andykarpov/karabas-128/README.md

# Karabas-128

**Yet another ZX Spectrum clone ;)**

## Intro

ZX Spectrum 128k replica with real **Z80** CPU and almost all logic in CPLD Altera **EPM7128STC100**. PCB designed to fit into original ZX Spectrum 48k (rubber keys) case.

## The idea

The idea was to make a **cheap** ZX Spectrum 128k clone with minimum components. Some parts of this schematics are grabbed from the **Superfo's Harlequin 48k** rev.G project (like AC/DC unit, tape in comparator, PAL coder). The heart of this project is real Z80 CPU and ULA implementation on Altera CPLD EPM7128STC100. CPLD design based on successor project **Speccy2007** by **syd** and it's modified version with single RAM IC by **.jackson**.

## More info

This is the first fabricated prototype PCB, it just works, it's fully tested, except small minor issues (please see ERRATA). 

For more information and assembly instructions please see **HOWTO**s in [English](https://github.com/andykarpov/karabas-128/blob/master/HOWTO-en.md) and [Russian](https://github.com/andykarpov/karabas-128/blob/master/HOWTO-ru.md).

**REVISION HISTORY** [English](https://github.com/andykarpov/karabas-128/blob/master/REVISIONHISTORY-en.md) and [Russian](https://github.com/andykarpov/karabas-128/blob/master/REVISIONHISTORY-ru.md).

**ERRATA for PCB rev.A:** [English](https://github.com/andykarpov/karabas-128/blob/master/ERRATA-revA-en.md) and [Russian](https://github.com/andykarpov/karabas-128/blob/master/ERRATA-revA-ru.md).

**ERRATA for PCB rev.B:** [English](https://github.com/andykarpov/karabas-128/blob/master/ERRATA-revB-en.md) and [Russian](https://github.com/andykarpov/karabas-128/blob/master/ERRATA-revB-ru.md).

**Latest revision:** [rev.B2](https://github.com/andykarpov/karabas-128-pcb).

Forum topic with discussion, new features and bugs is here: [zx-pk.ru](http://zx-pk.ru/threads/27724-karabas-128.html). (mostly russian-only).

License for this project is **WTFPL**. [More details here](https://github.com/andykarpov/karabas-128/blob/master/LICENSE.md).

(https://www.seeedstudio.com/Karabas-128-rev-A-g-1008690)

### First working device:

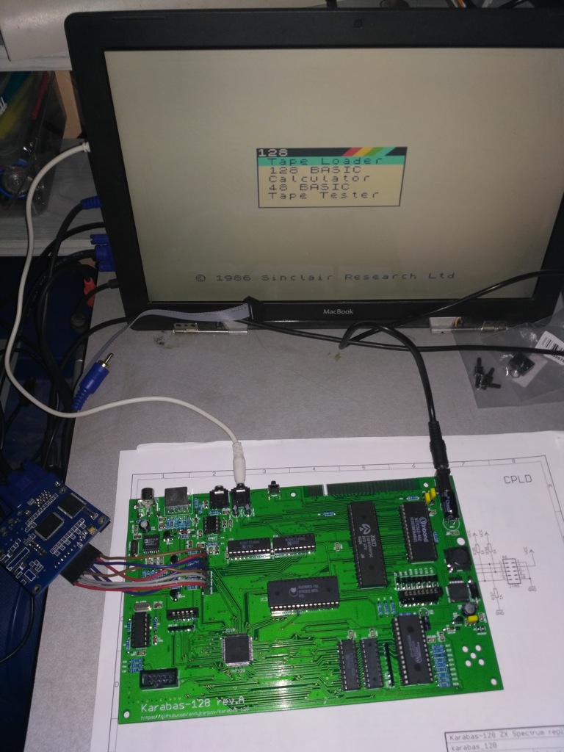
[picture p1: docs/progress10.jpg]


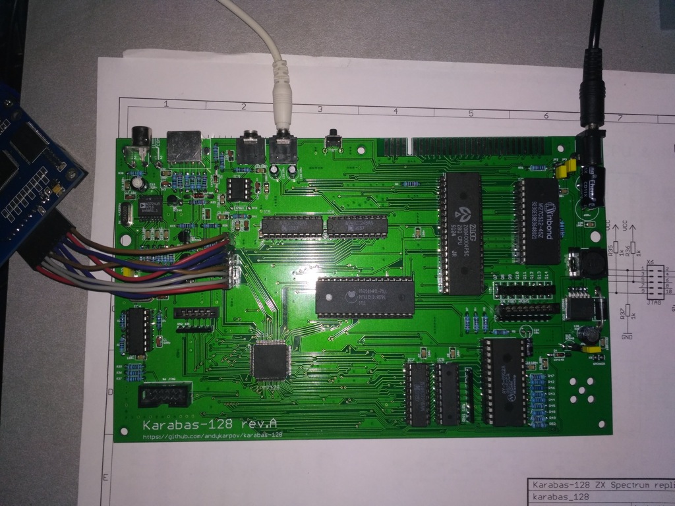
[picture p2: docs/progress11.jpg]


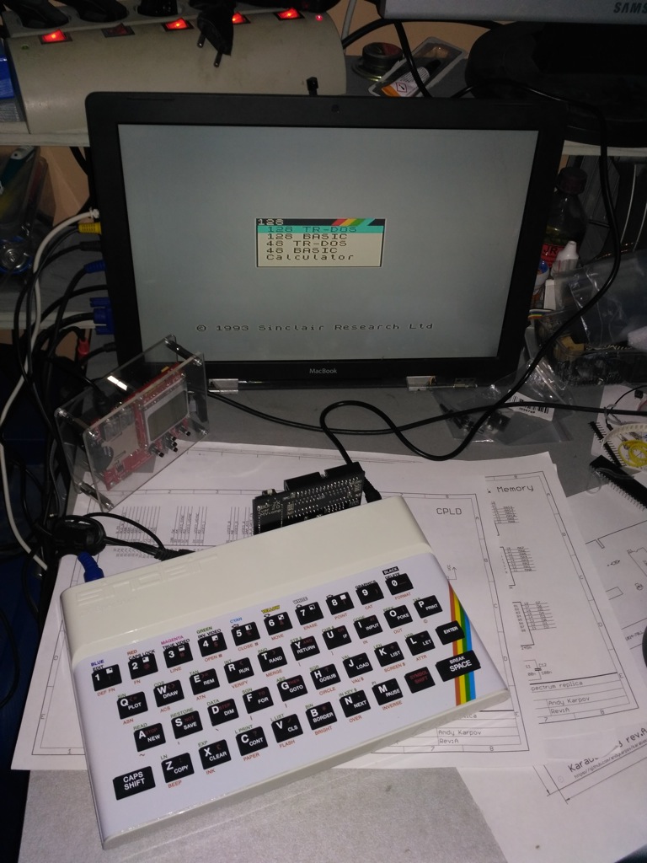
[picture p3: docs/progress12.jpg]


### Pre-production renders:

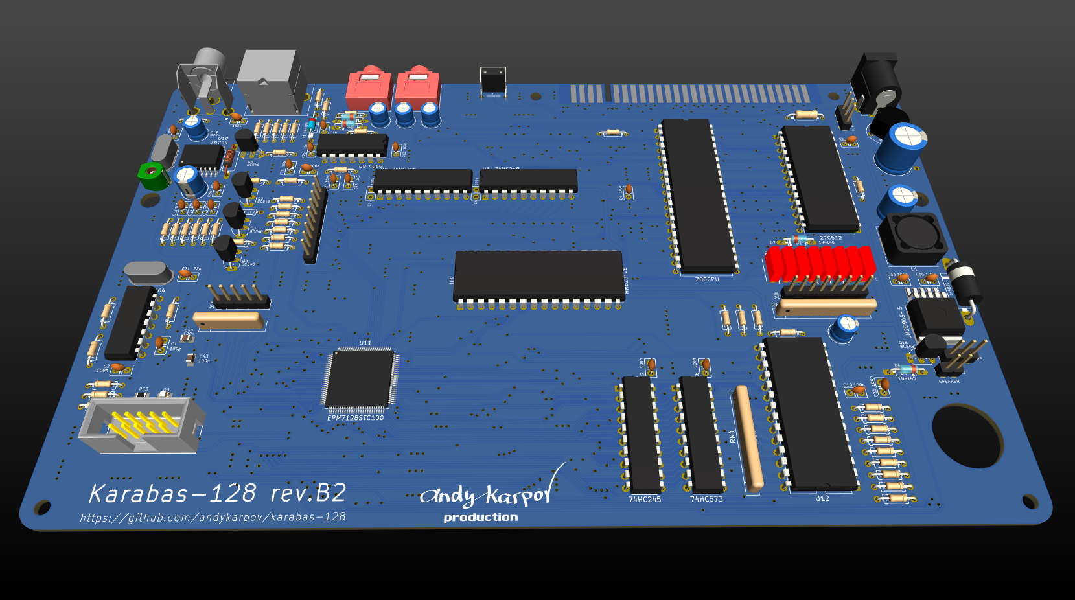
[picture p4: docs/karabas_128_3d.png]


### Prototype photos:

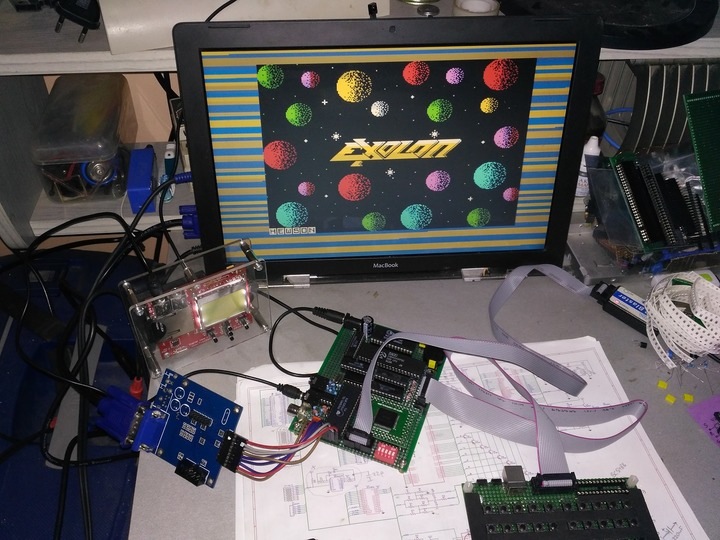
[picture p5: docs/progress6.jpg]


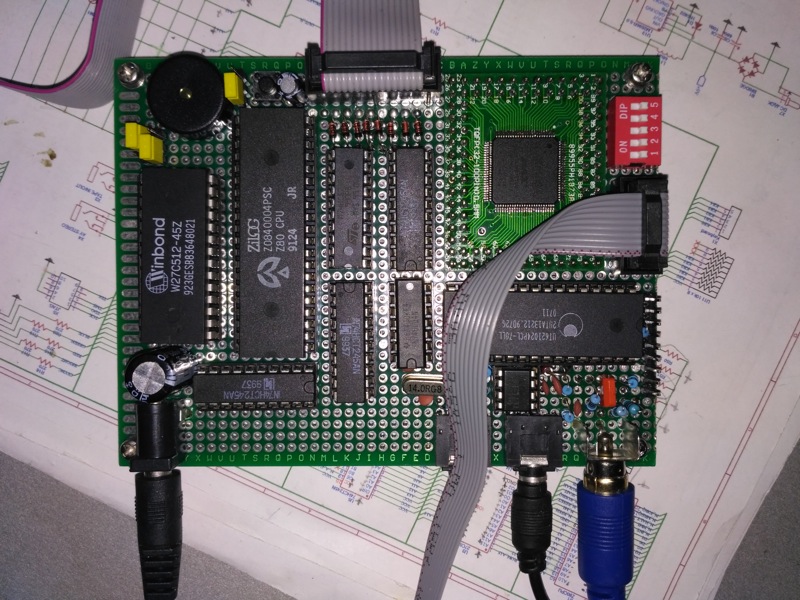
[picture p6: docs/progress4.jpg]


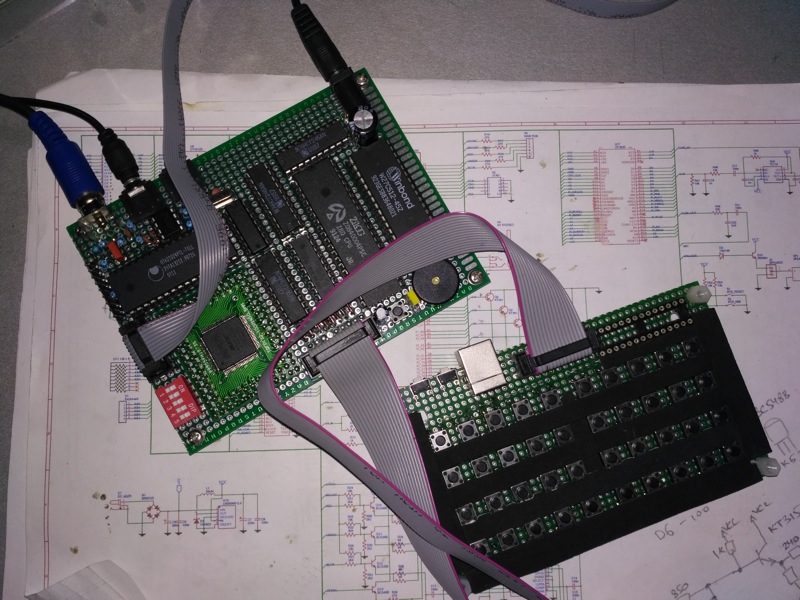
[picture p7: docs/progress5.jpg]
