andykarpov/karabas-128/docs/progress3.jpg

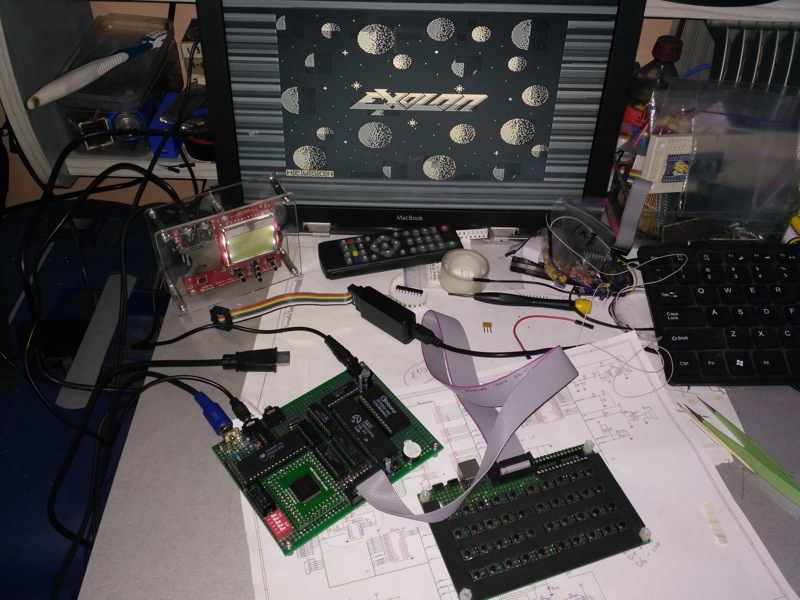
docs/progress3.jpg
