andykarpov/karabas-128/docs/progress7.jpg

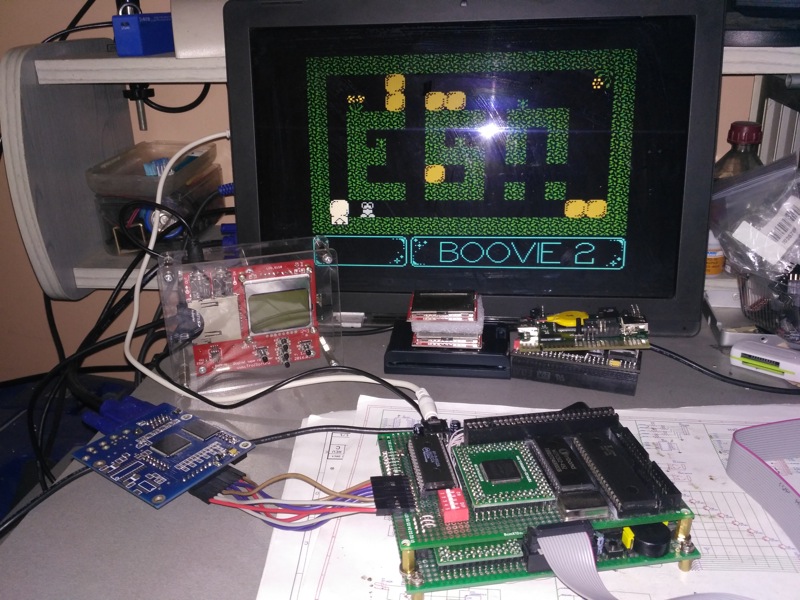
docs/progress7.jpg
