andykarpov/karabas-128/docs/progress8.png

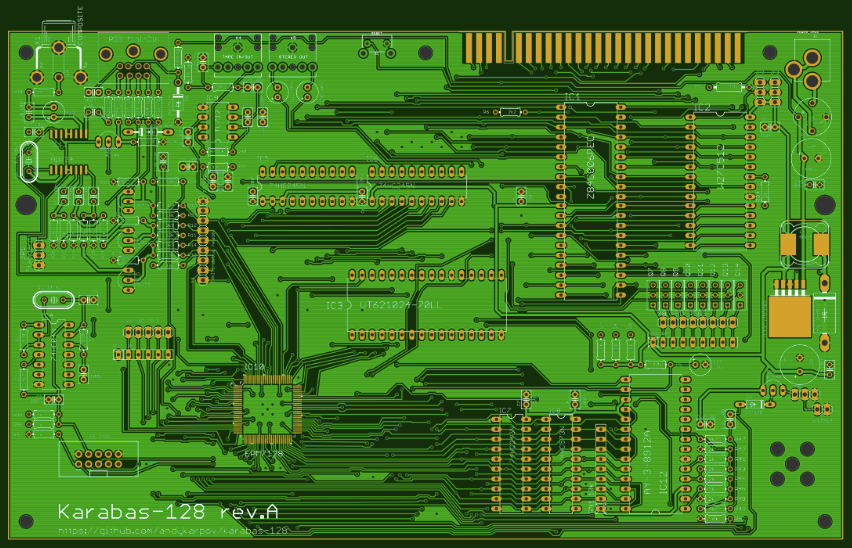
docs/progress8.png
