andykarpov/karabas-128/docs/progress9.png

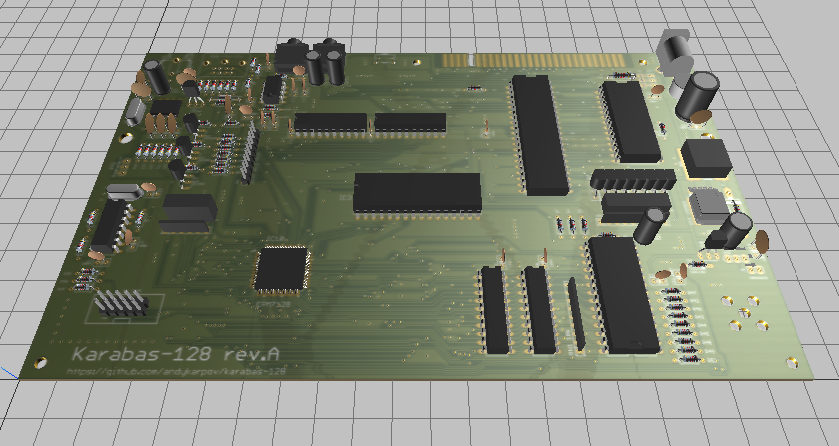
docs/progress9.png
