andykarpov/karabas-128/docs/progress13.png

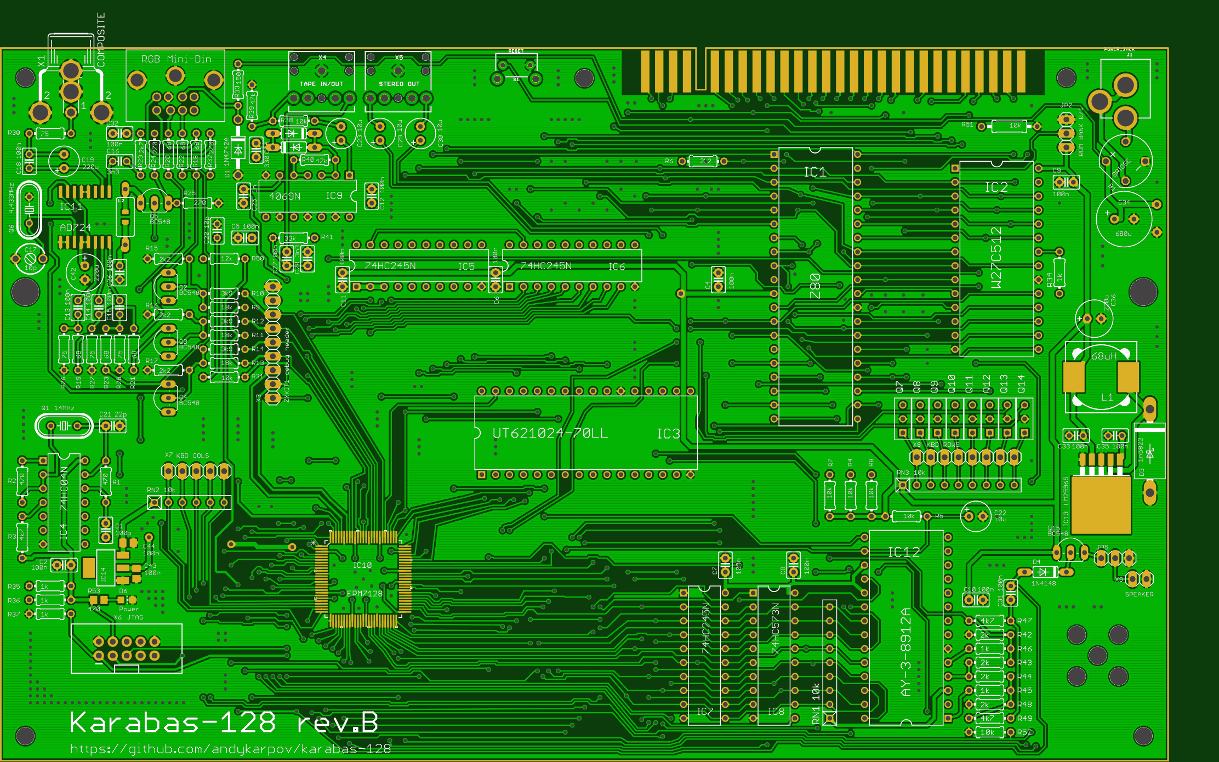
docs/progress13.png
