andykarpov/karabas-128/docs/progress13b.png

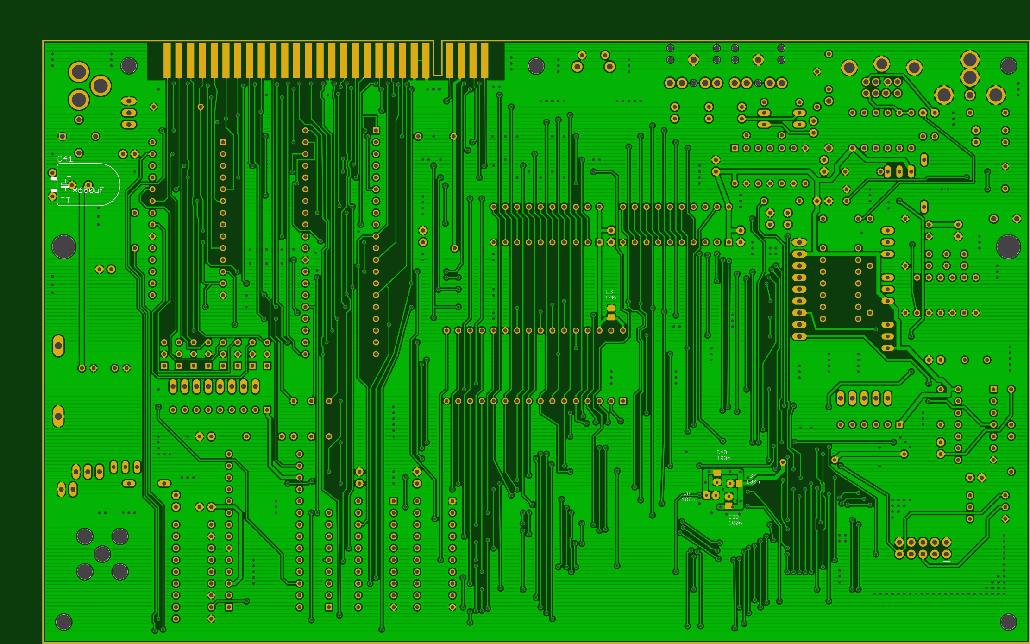
docs/progress13b.png
