andykarpov/karabas-128/docs/progress14.png

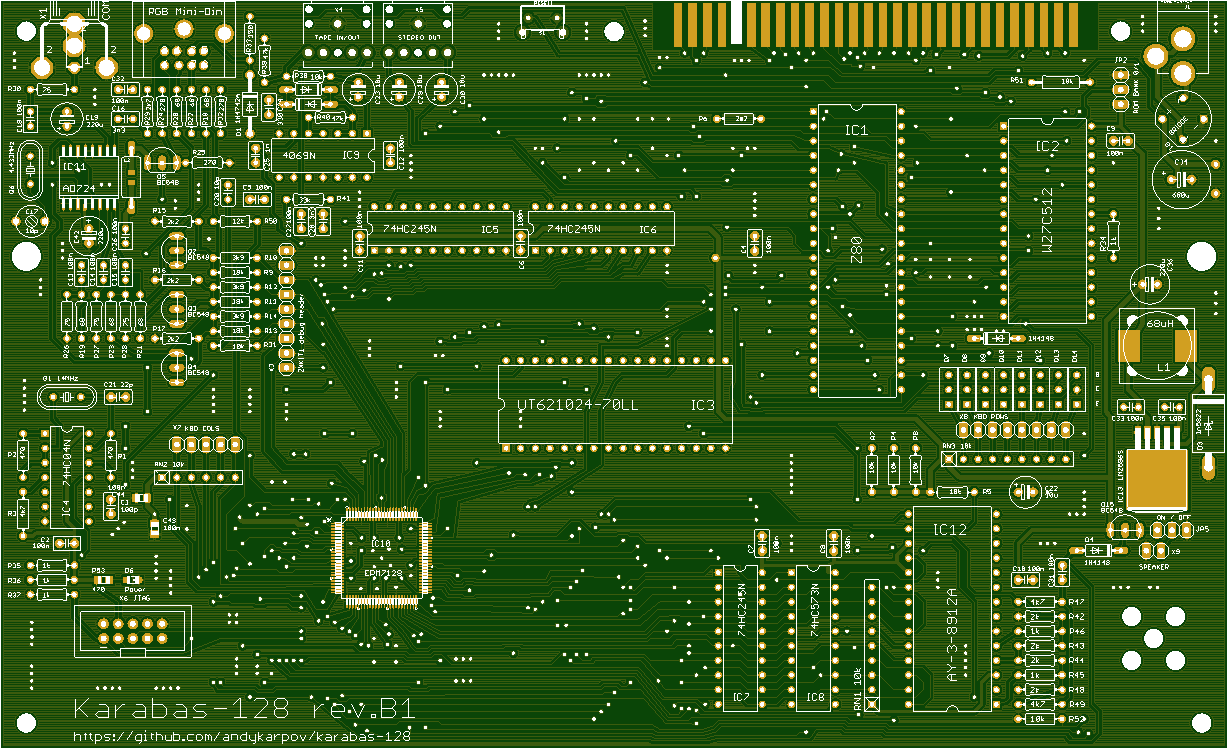
docs/progress14.png
