andykarpov/karabas-128/docs/progress15b.png

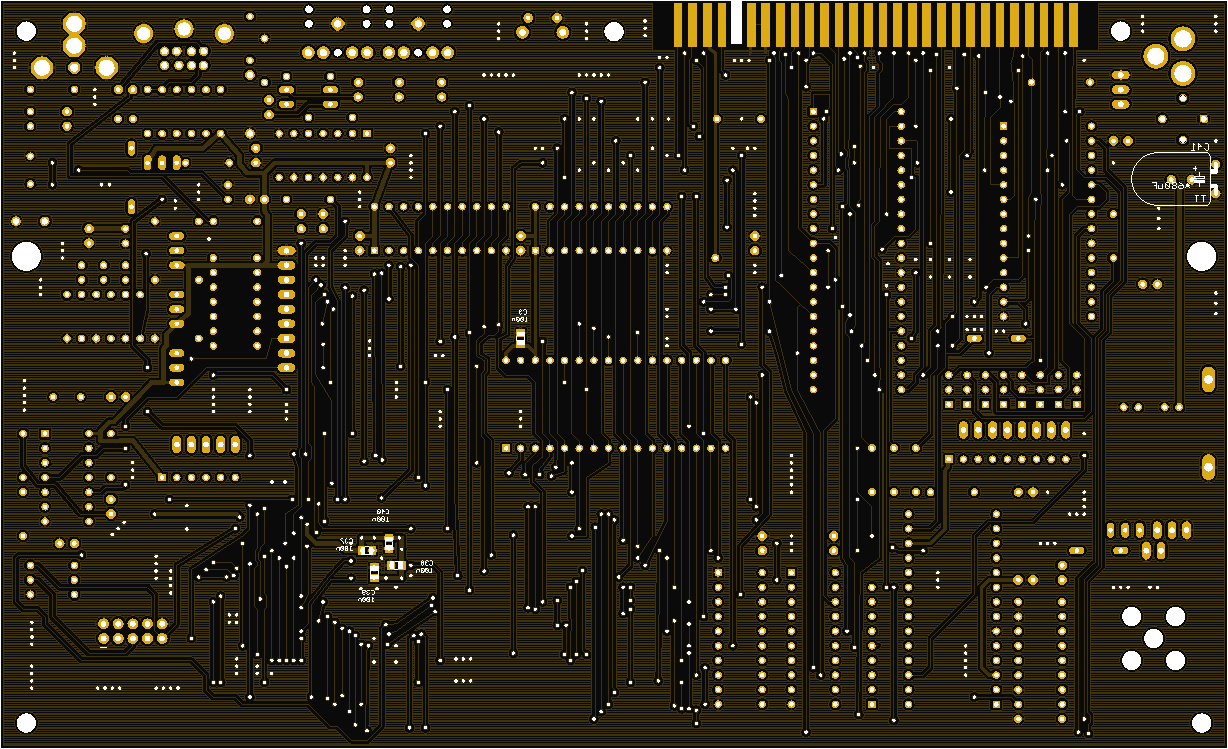
docs/progress15b.png
