andykarpov/karabas-128/REVISIONHISTORY-ru.md

# История ревизий Karabas-128:

## Ревизия A

Первая работающая ревизия karabas-128.
Информацию по багам и нюансам смотрите в ERRATA.

## Ревизия B

- Исправлен баг в неправильно разведенном коннекторе RGB (спасибо Nika за помощь в поиске бага)

- Переразведены силовые линии, должно помочь с шумами от LM8596

- Добавлена индуктивность + конденсаторы на AD724 для понижения наводок от цифровой части

- Добавлен подстроечный конденсатор для точной регулировки AD724

- Модуль чтения с ленты на TL712 заменен на модуль на базе CD4069 (спасибо tank-uk за идею и реализацию)

- Добавлен 3.3В регулятор для поддержки EPM3128

- Добавлен светодиод для индикации наличия питания

## Ревизия B1

- сигнал CLK_BUS на краевом слоте ZX BUS разведен с помощью одного из свободных инверторов IC4 (спасибо Ricardo Saraiva за обнаружение бага)

- Убран регулятор 3.3В, так как EPM3128 имеет меньшее количество i/o линий, что катастрофически для Карабаса

- Добавлен диод между A11 и N_RESET для поддержки переключения режимов по RESET+1, RESET+2 (спасибо solegstar за идею и реализацию!)

## Ревизия B2

- Импорт проекта в Kicad

- Небольшая косметика
