andykarpov/karabas-128/ERRATA-revB-ru.md

# ERRATA для платы ревизии B:

1) LDO регулятор на 3.3В не нужен, вместо него нужно запаять перемычку

2) Сигнал CLK на краевом слоте ZX BUS не инвертирован. Это может привести к проблемам с периферией, которые используют данный сигнал, например DivMMC. 
Возможный фикс: завести сигнал через один из свободных элементов IC4. Для этого отрезать сигнал CLK от ZX BUS и запустить его (с 6 ноги Z80) на 5 ногу IC4, снять с 6 ноги IC4.
