andykarpov/karabas-128/ERRATA-revA-ru.md

# ERRATA для платы ревизии A:

1) LM2596S разведена несколько криво, поэтому по питанию наблюдается шум. Возможный фикс: напаять SMD-керамику на вход / выход микросхемы + электролит C36 припаять как можно ближе к точке разветвления после дросселя. То, где сейчас находится C36 - не совсем правильно. Также C36 должен быть с низким ESR (согласно datasheet'а для AD724).

2) Наблюдаются помехи по питанияю для AD724. Возможное решение: добавить дроссель в разрыв цепи питания 5В в непосредственной близости от аналоговой части + на саму AD724 навесить керамику и электролит на питание, по возможности близко к микросхеме. Пример: [http://zx-pk.ru/threads/27724-karabas-128.html?p=920355&viewfull=1#post920355](http://zx-pk.ru/threads/27724-karabas-128.html?p=920355&viewfull=1#post920355)

3) Разъем MiniDin8 для RGB выхода отзеркален. Возможное решение: не пользоваться этим разъемом, либо почикать все дорожки, которые к нему идут и с помощью МГТФ сделать патч, либо спаять провод для RGB в соответствии с реальным положением дел.

4) Сигнал CLK на краевом слоте ZX BUS не инвертирован. Это может привести к проблемам с периферией, которые используют данный сигнал, например DivMMC. 
Возможный фикс: завести сигнал через один из свободных элементов IC4. Для этого отрезать сигнал CLK от ZX BUS и запустить его (с 6 ноги Z80) на 5 ногу IC4, снять с 6 ноги IC4.
