andykarpov/karabas-128/docs/Karabas-128-sch-revB2.pdf

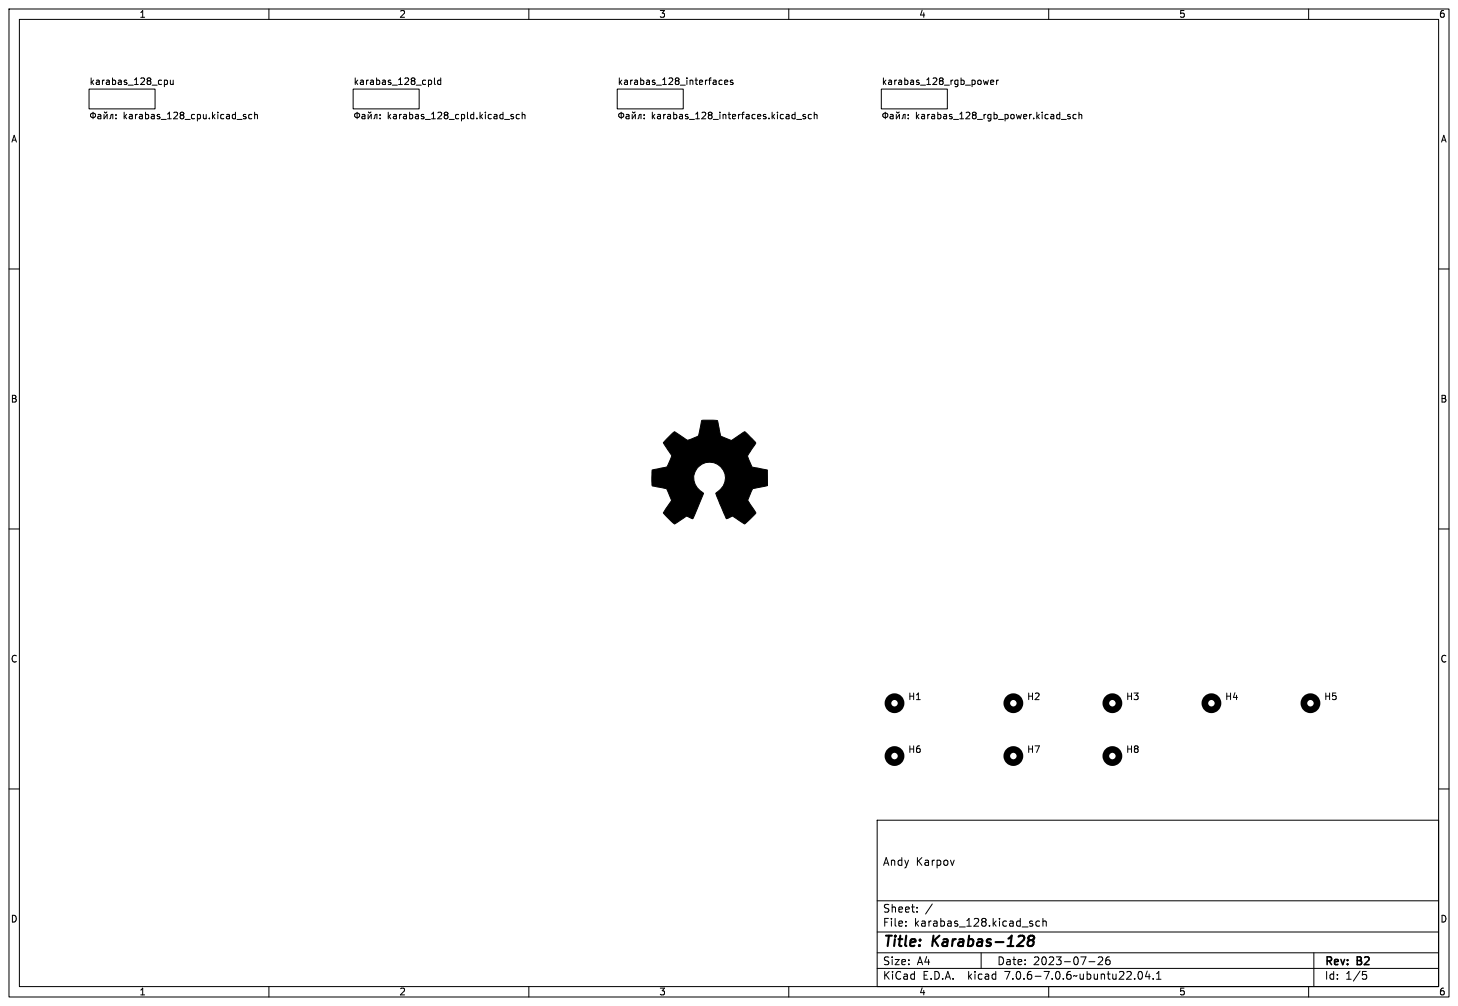
[picture p17: page 1]

File: karabas_128.kicad_sch Sheet: / Andy Karpov

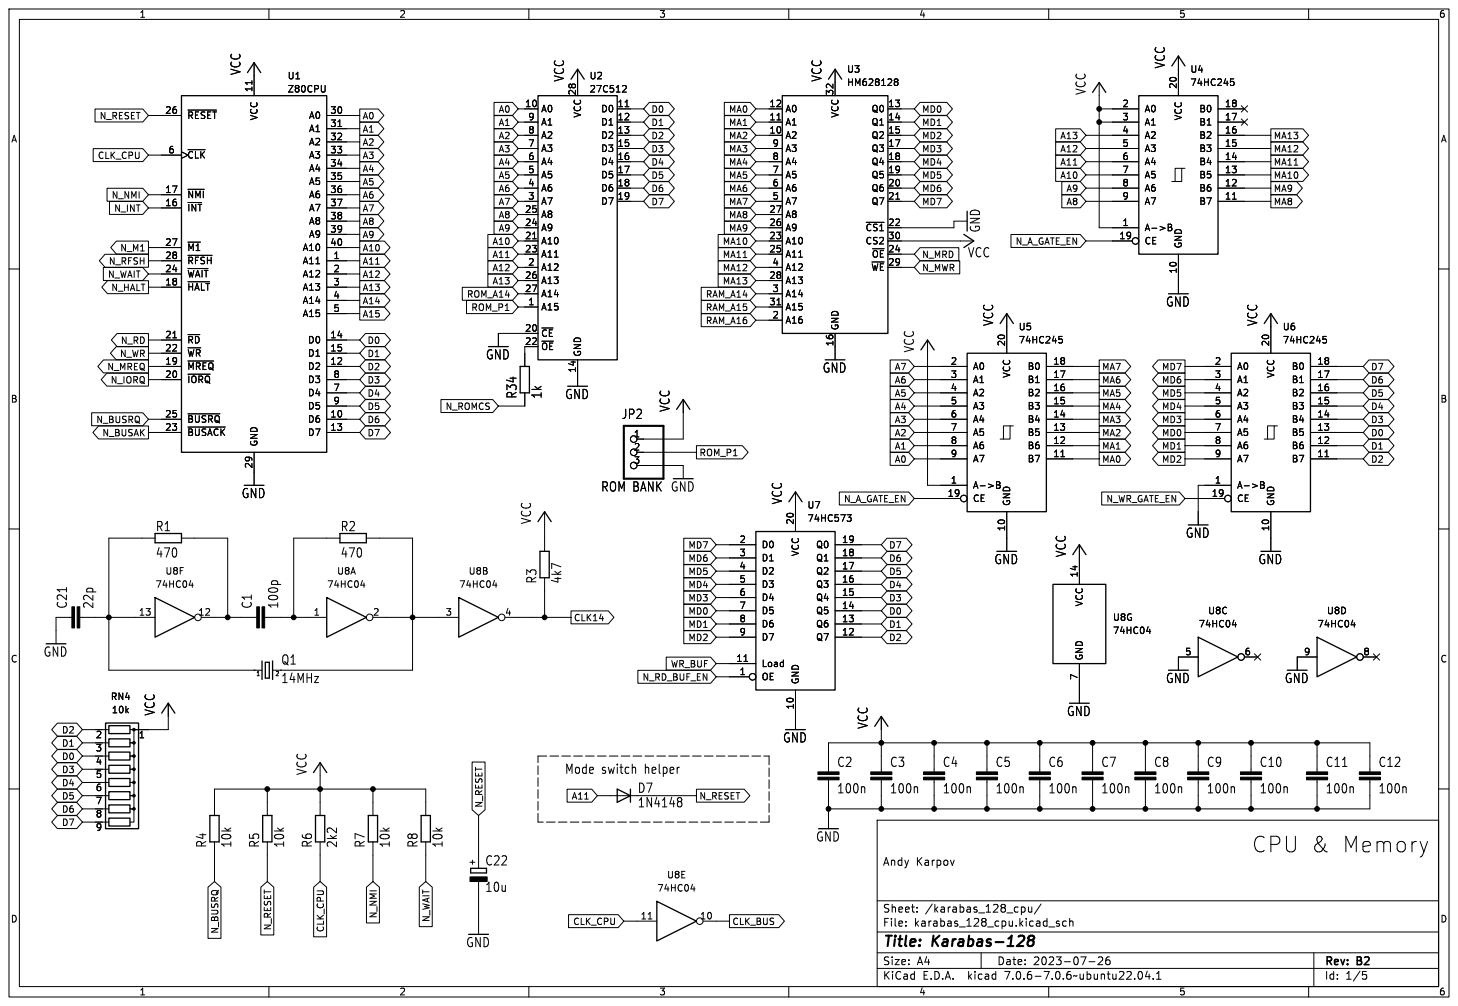
[picture p18: page 2]

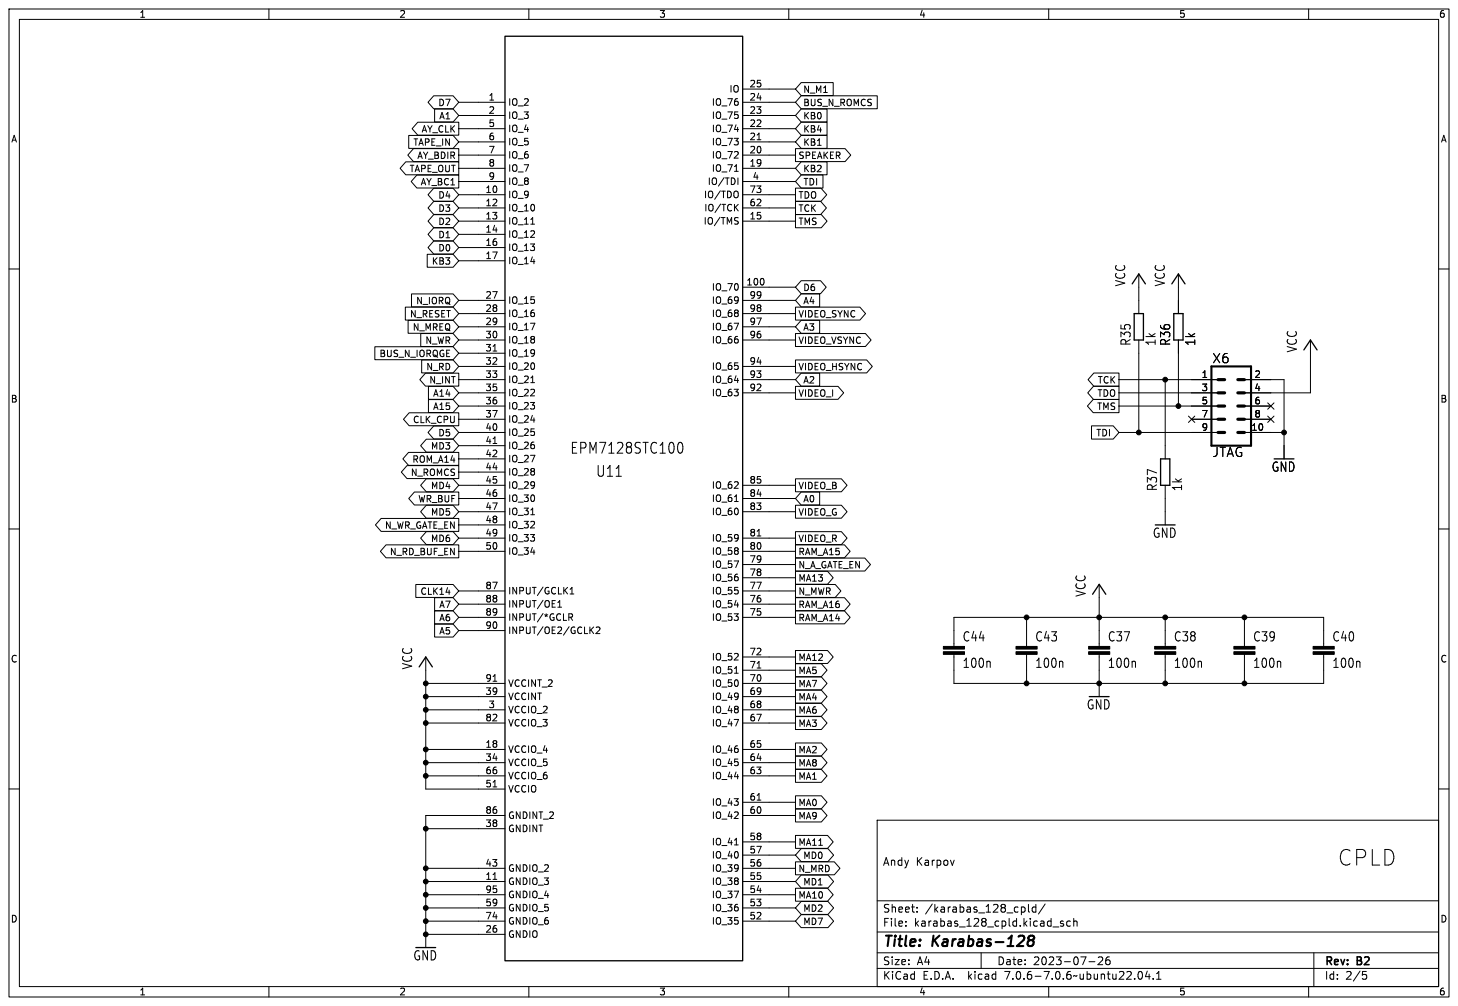
[picture p19: page 3]

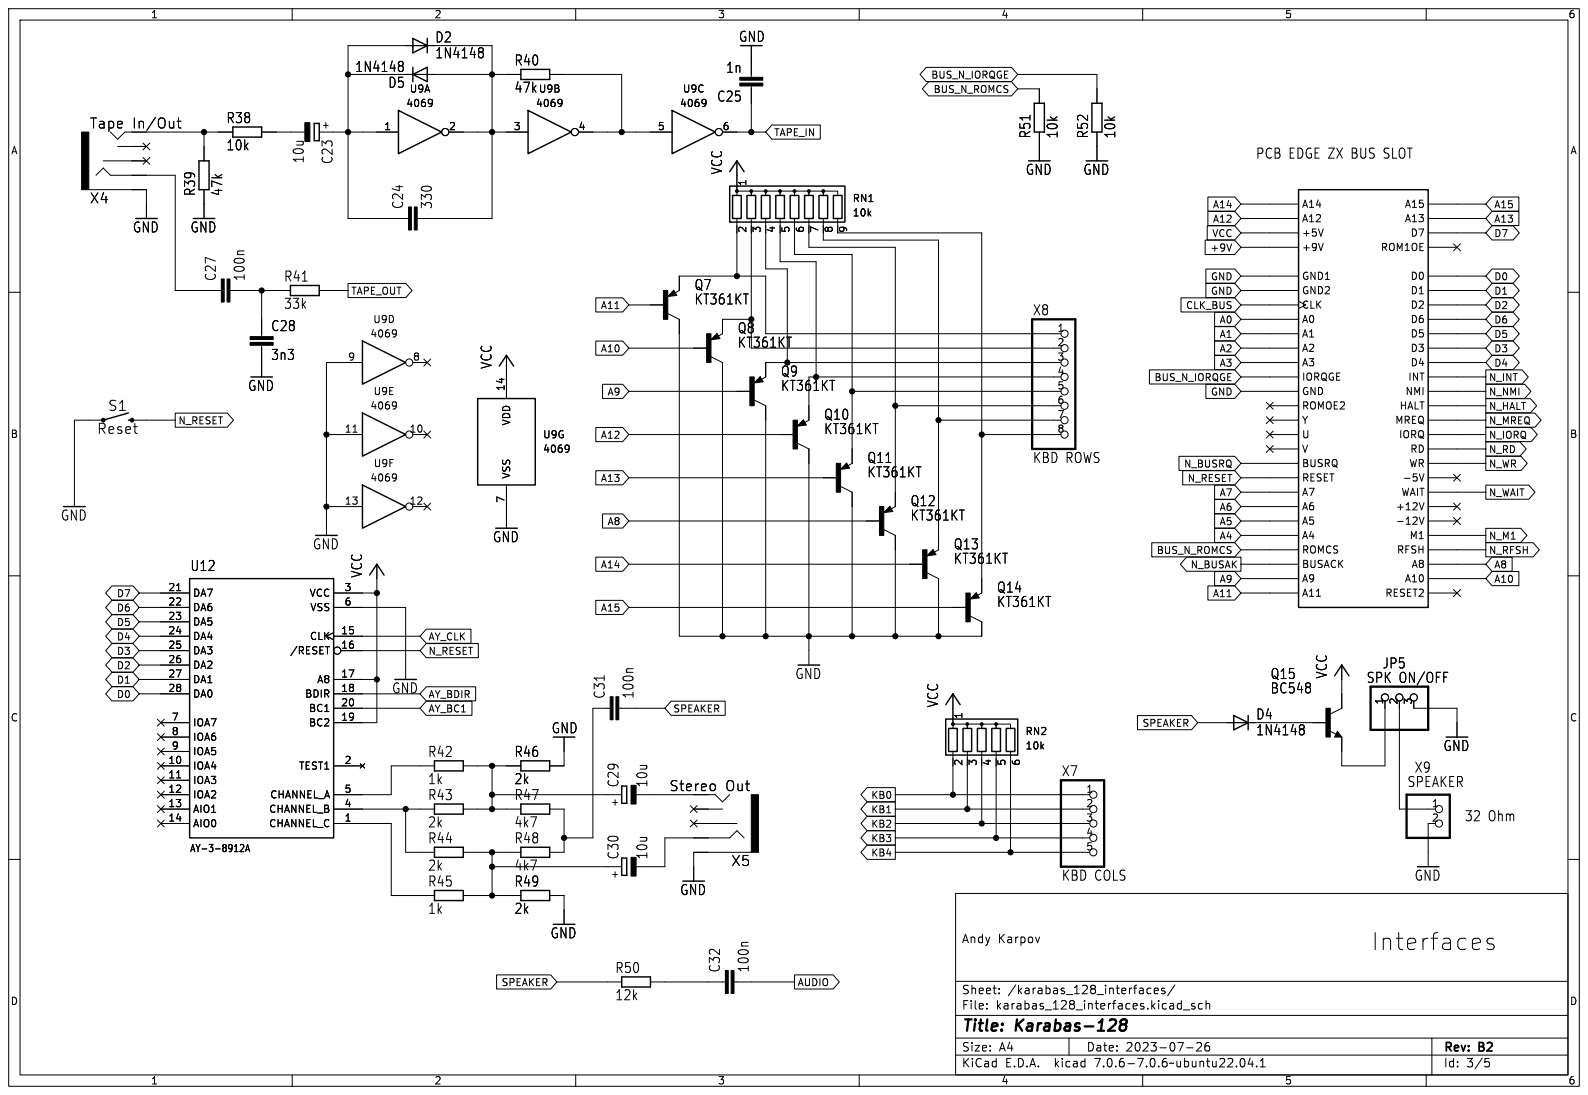
[picture p20: page 4]

PCB EDGE ZX BUS SLOT

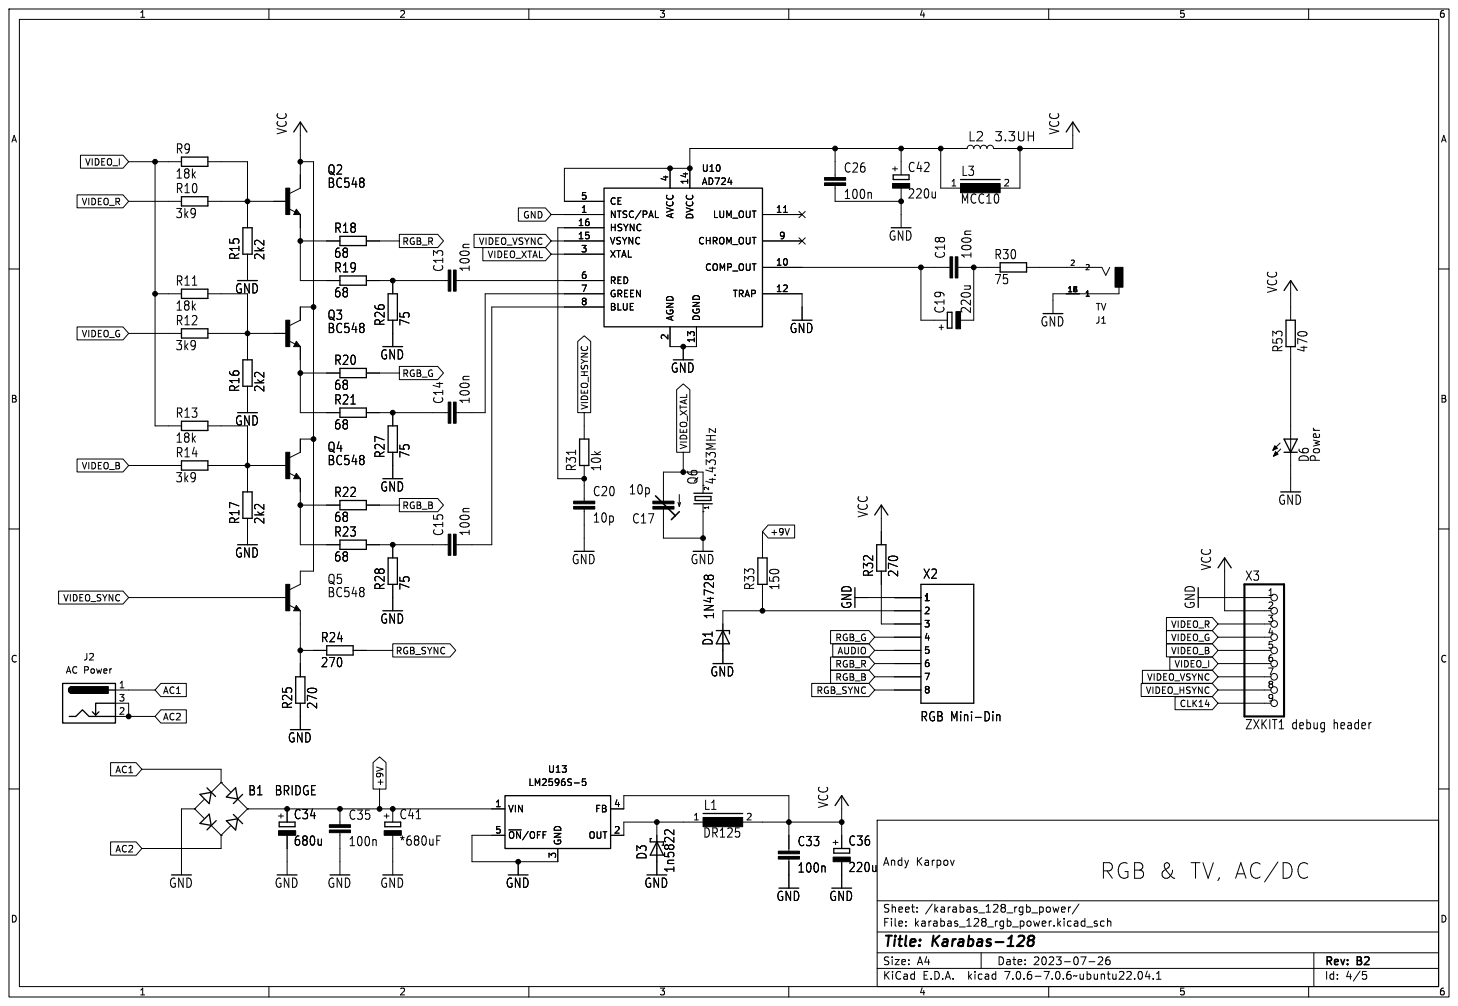
[picture p21: page 5]

4 CE 5 RED 6 GREEN 7 BLUE 8 CHROM_OUT 9 U10 AD724 1 2 L3

4 CE 5 RED 6 GREEN 7 BLUE 8 CHROM_OUT 9 GND

3 FB 4 ~{ON}/OFF 5 GND
