andykarpov/karabas-128/docs/Karabas-128-cmp-revB1.pdf

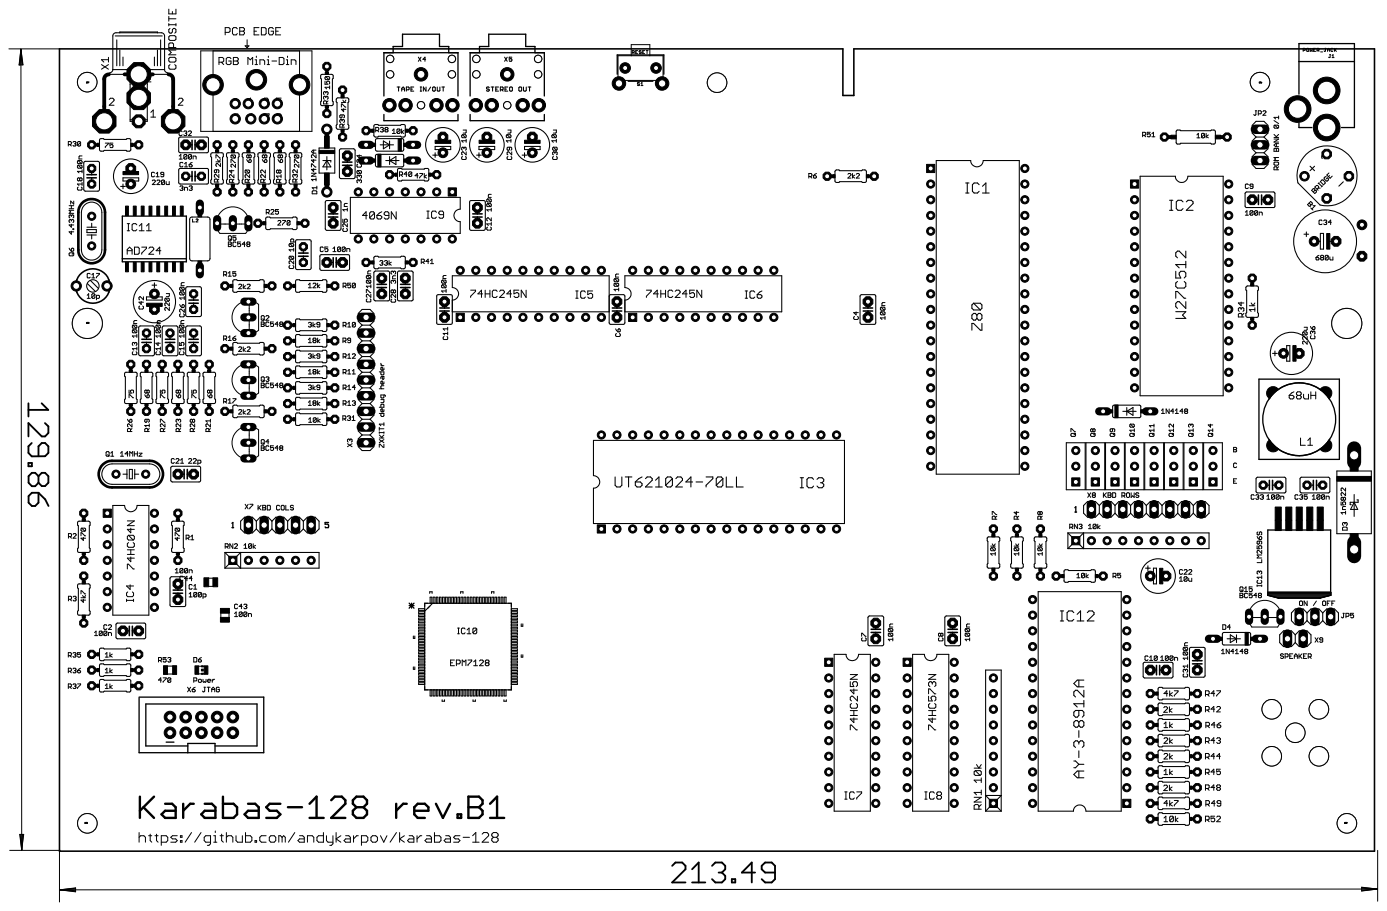
[picture p22: page 1]
