andykarpov/karabas-128/docs/Karabas-128-sch-revB1.pdf

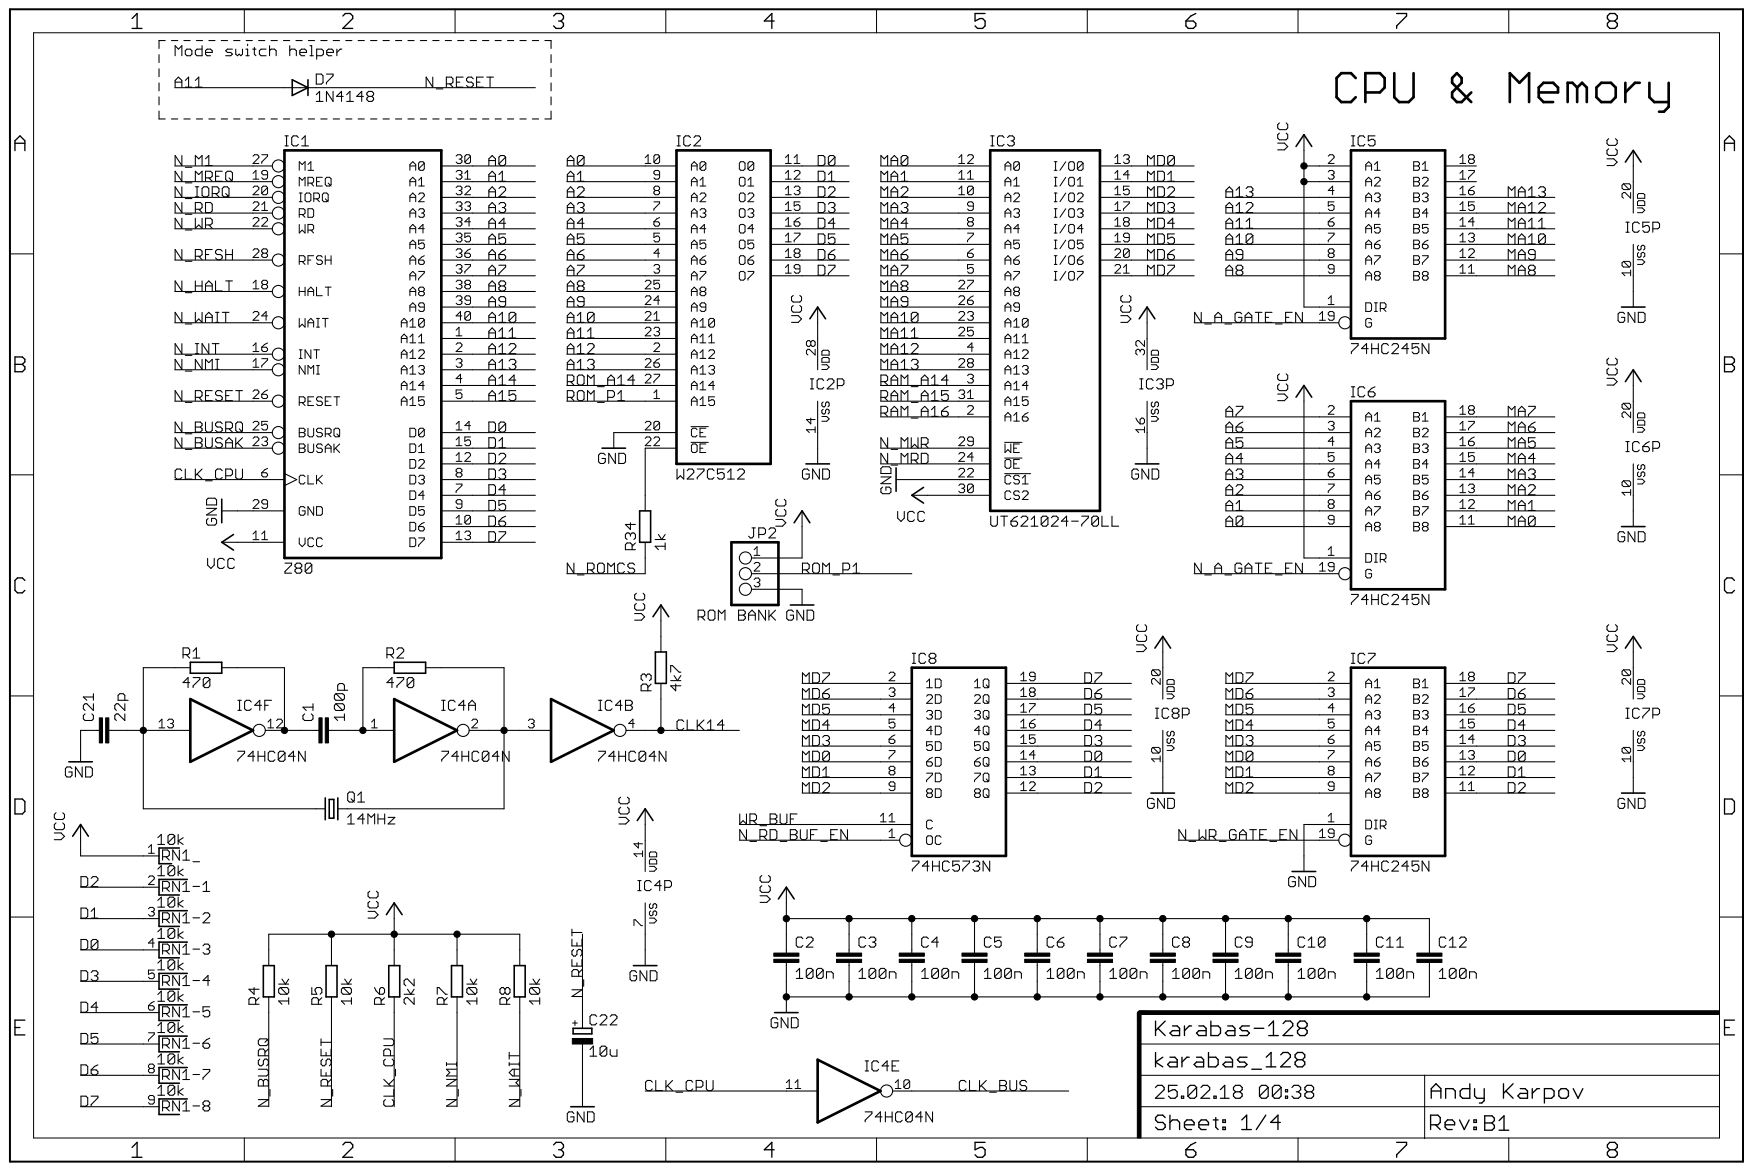
[picture p23: page 1]

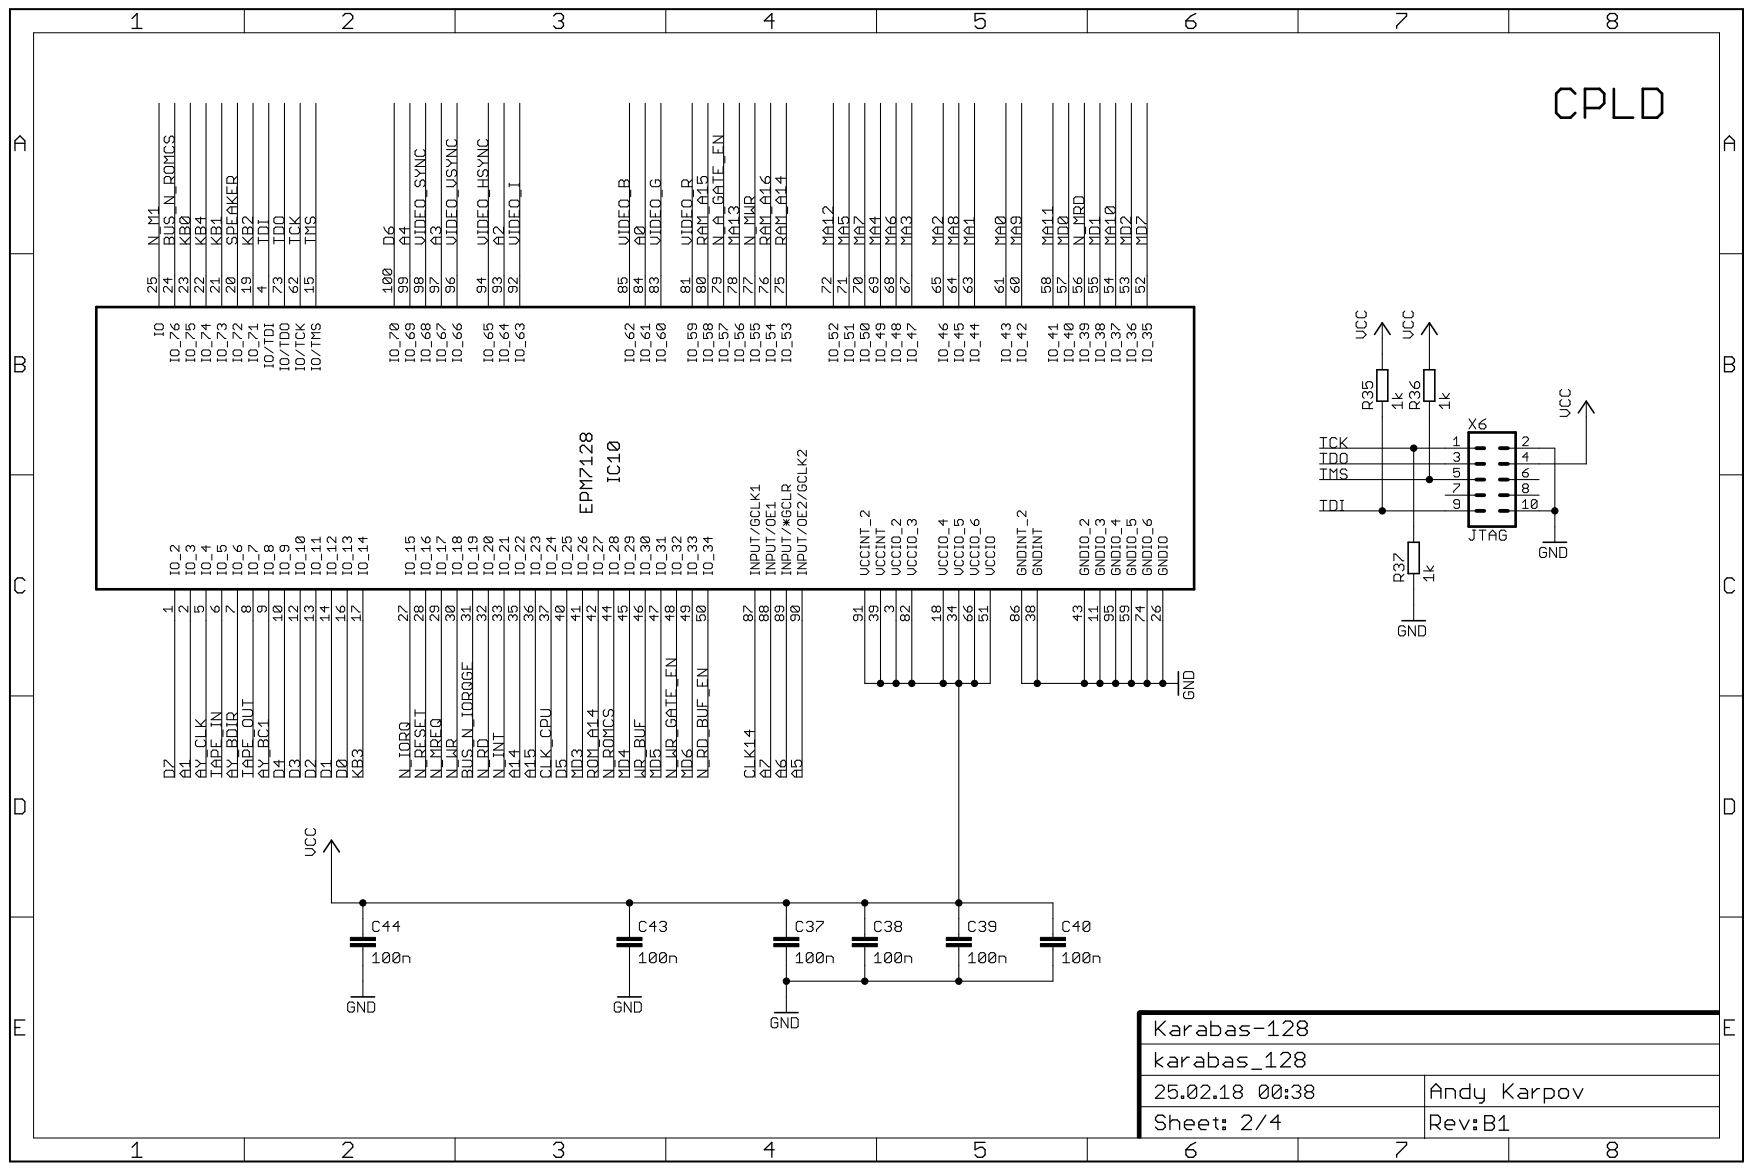
[picture p24: page 2]

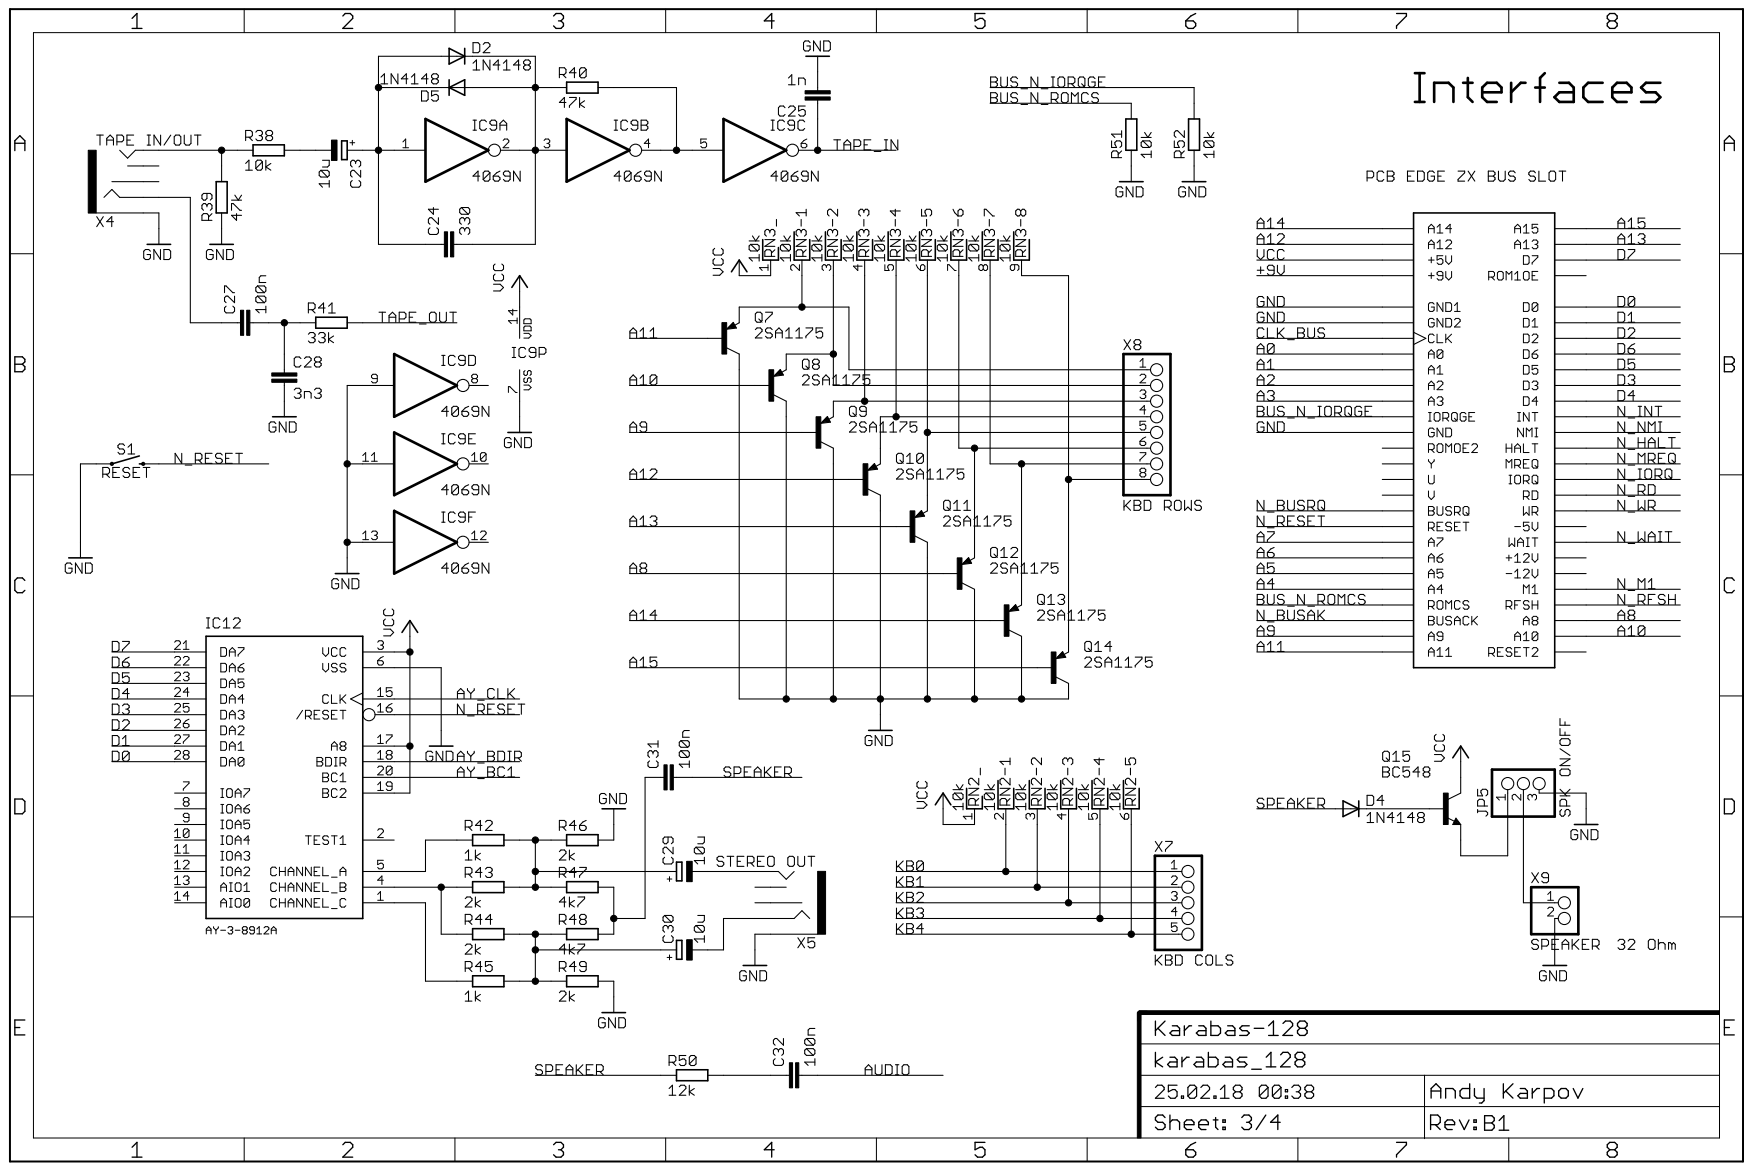
[picture p25: page 3]

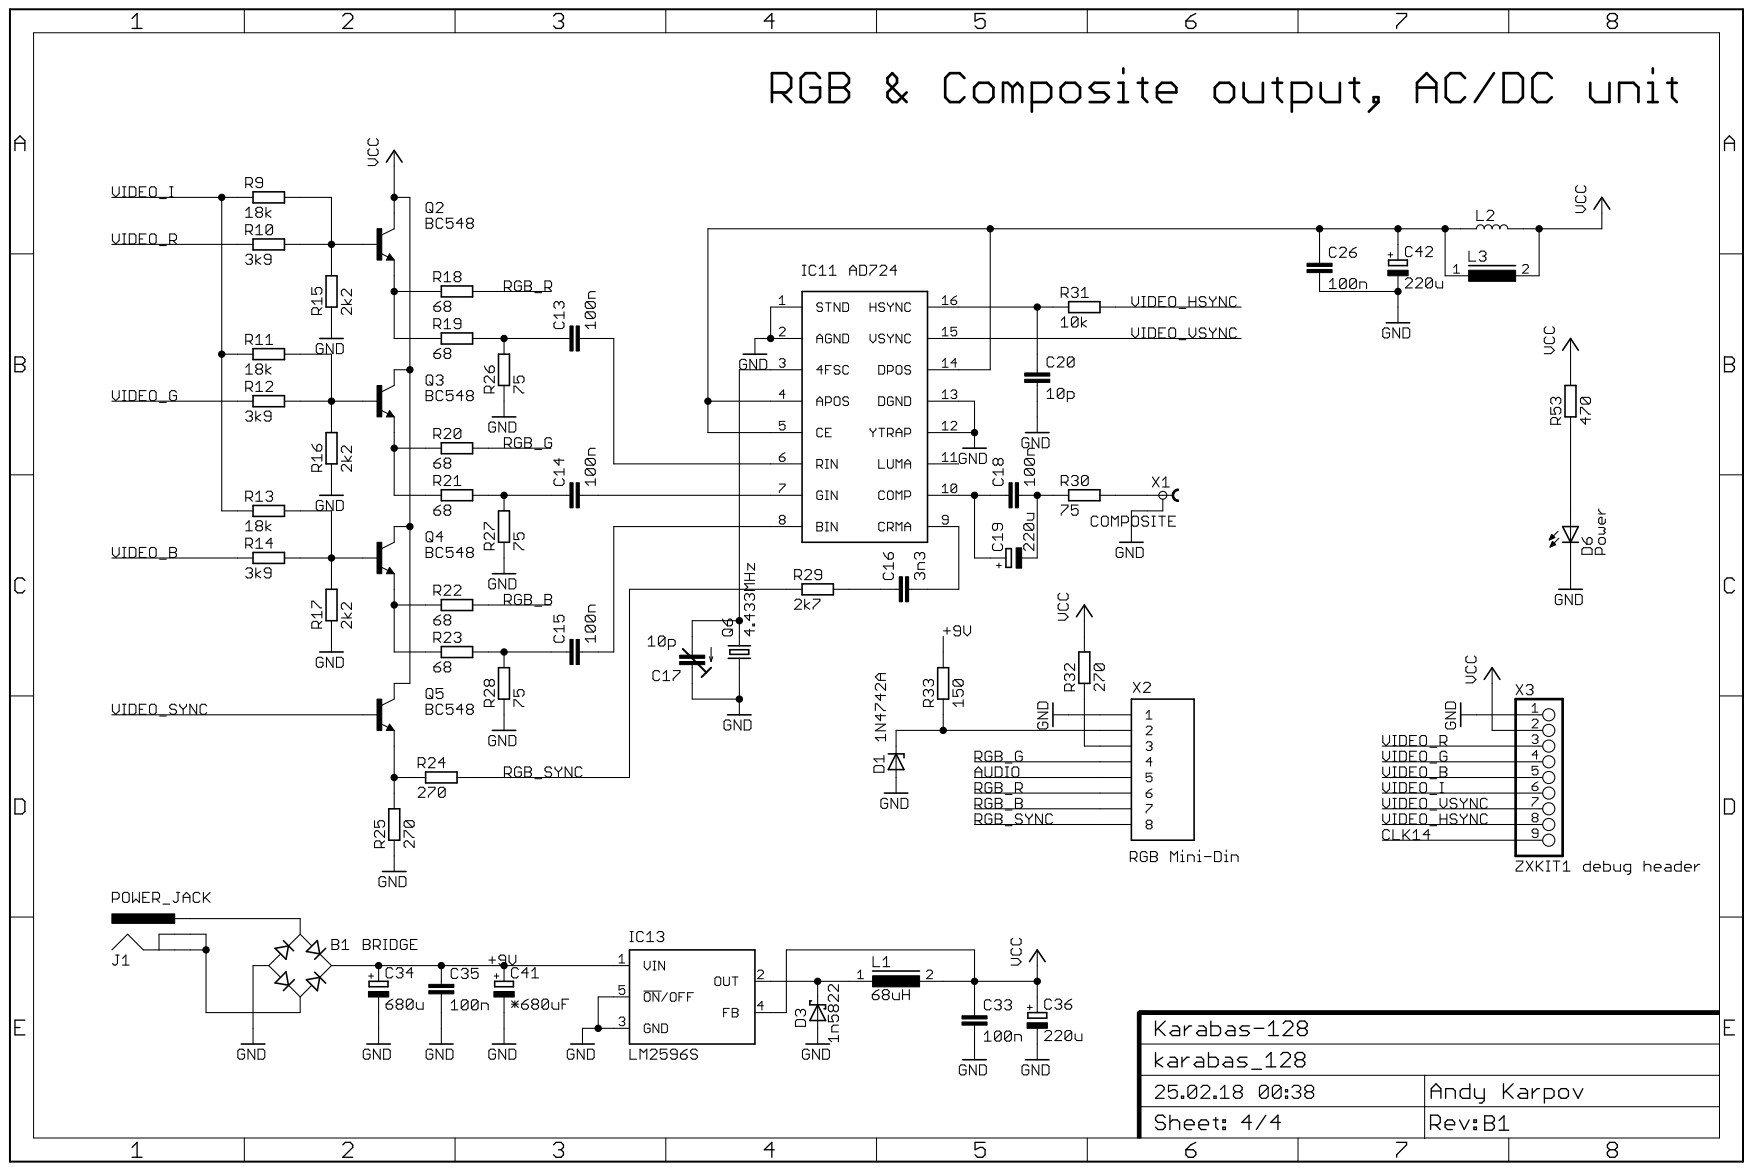
[picture p26: page 4]
