andykarpov/karabas-128/docs/Karabas-128-cmp-revB.pdf

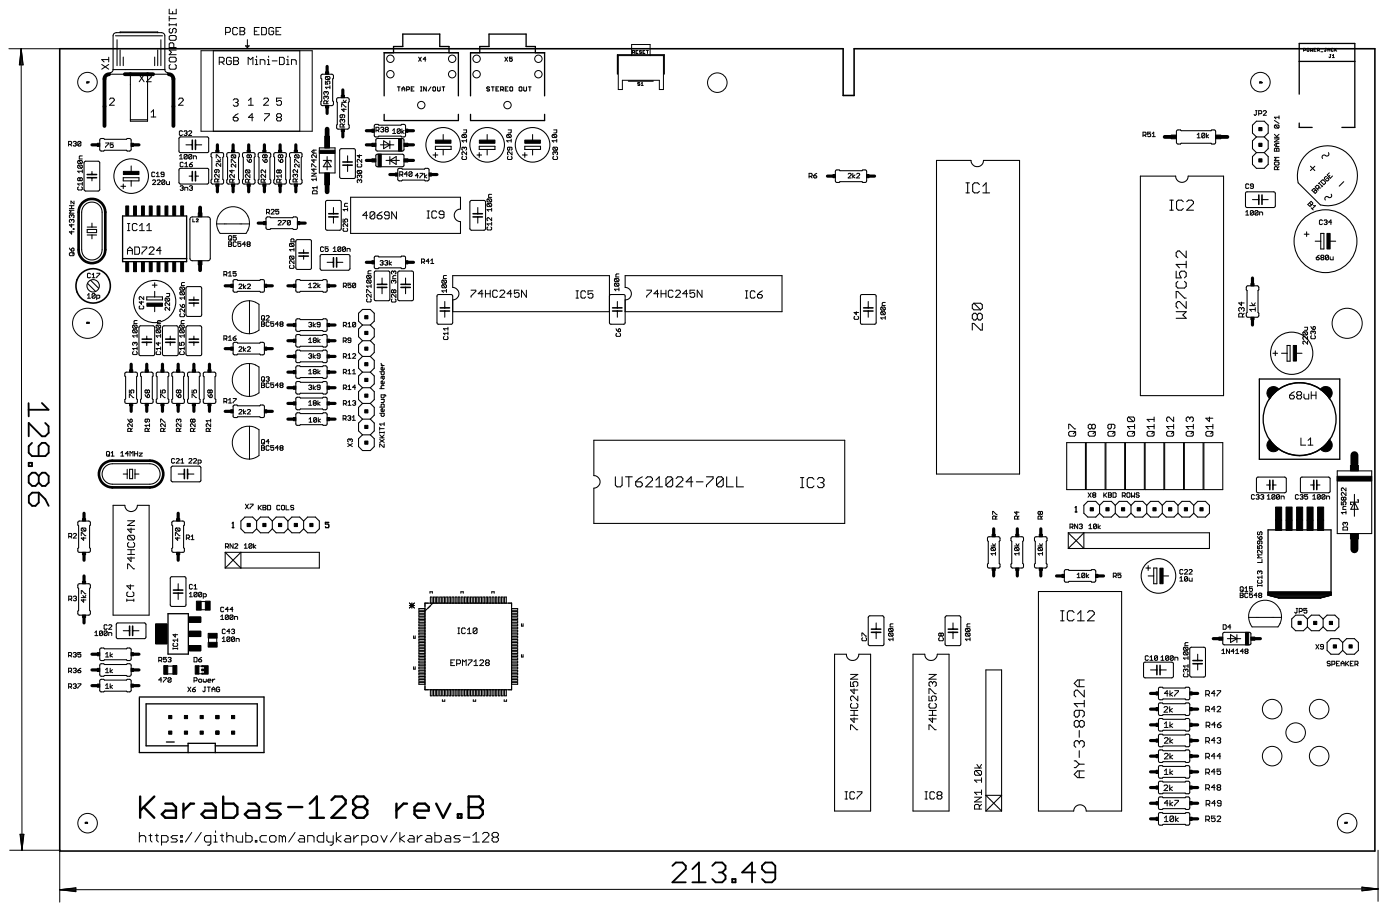
[picture p27: page 1]
