andykarpov/karabas-128/docs/Karabas-128-cmp-revA.pdf

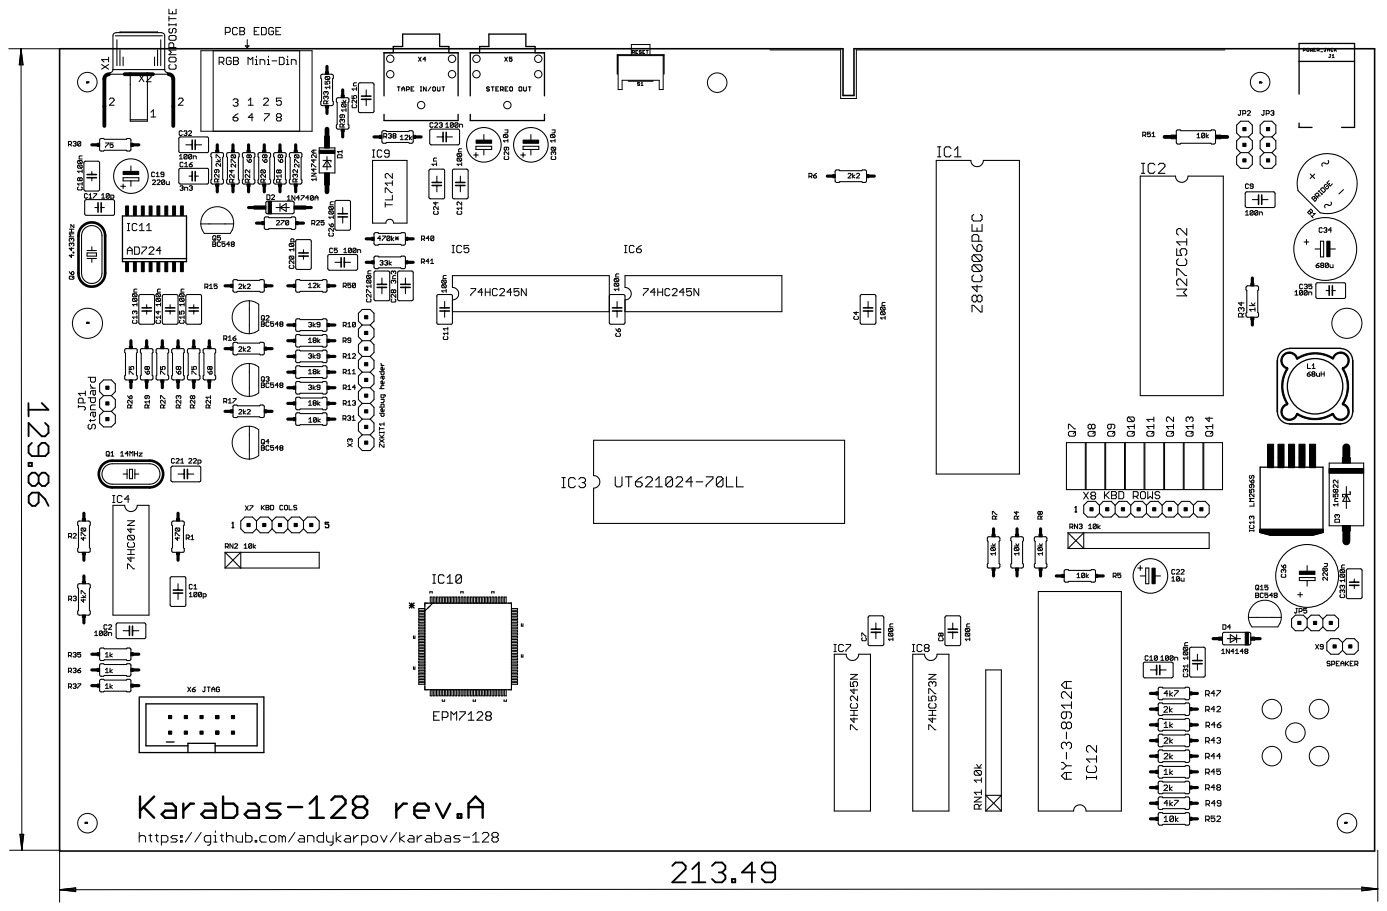
[picture p36: page 1]
