andykarpov/karabas-128/(commit log)

2017-05-16 Added port #FE, refactored signal names and external pin mapping
2017-05-17 added timings for zxkit1 vga converter, details are here: http://zx-pk.ru/threads/10728-zxkit1-plata-vga-amp-pal-priem-zakazov.html?p=215147#post215147
2017-05-18 added mode switch
2017-05-18 switched to mode2 (pentagon)
2017-05-19 Updated schematics diagram
2017-05-19 Schematics backup from EasyEDA
2017-05-19 updated schematics
2017-05-27 reverted ROMCS bus signal
    [karabas_128.vhd]
2017-05-28 Updated schematics and progress
2017-06-03 gerbers and components layout pdf
2017-06-03 schematic fixes
2017-06-03 updated gerbers
2017-06-04 added BOM list
2017-06-04 Added BOM list as useful PDF
2017-06-04 removed plaintext BOM list
2017-06-04 3d pcb preview
2017-06-23 Pin assignments as readable csv file
    [karabas_128_assignments.csv]
2017-06-27 Added assembly instructions, english
2017-07-19 changed logic for AY signals BC1, BDIR against this schematics: https://zxpress.ru/article.php?id=11995
2017-07-23 New PCB rev.B
2017-07-23 updated schematics and components side view for rev.B
2017-07-24 Fixed BOM list for PCB rev.A
2017-07-30 Fixed port #FE decoding (moved from full to short decoding)
    [karabas_128.vhd]
2017-08-01 Playground with port #FE - added a short decoding (by A0 only) for read / write
    [karabas_128.vhd]
2017-08-18 Added ERRATA corrections in the schematics for rev.A
2017-09-21 New universal firmware from solegstar with soft switch between pentagon and classic-48 sync modes
2017-09-25 Fixed hsync / vsync for both pentagon / ula48 mode
    [karabas_128.vhd]
2018-02-20 Добавлено описание ошибок сигнала CLK на шине ZX BUS
2018-02-25 rev B1 BOM list
2018-02-25 updated gerbers for revB1
2018-10-10 fixed N_ROM_CS signal (credits goes to Vlad)
    [karabas_128.vhd]
2020-05-24 Fixed rev.B1 gerbers (removed aperture D19)
2020-08-15 Fixed B1 gerbers
2024-10-09 Fix high-Z RGB signals and intensity to not show 'intense black' (#2)
    as usual, the Spectrum clones display "high intensity black" as gray because they enable intensity -line of RGBI even there is no color information.
    [karabas_128.vhd]
